TheSeagullDev/wright-1/hardware/wright-I.kicad_pcb

## KiCad design Big Daddy-2025-04-11_172858/Big Daddy-2025-04-11_172858/Big Daddy.kicad_pcb

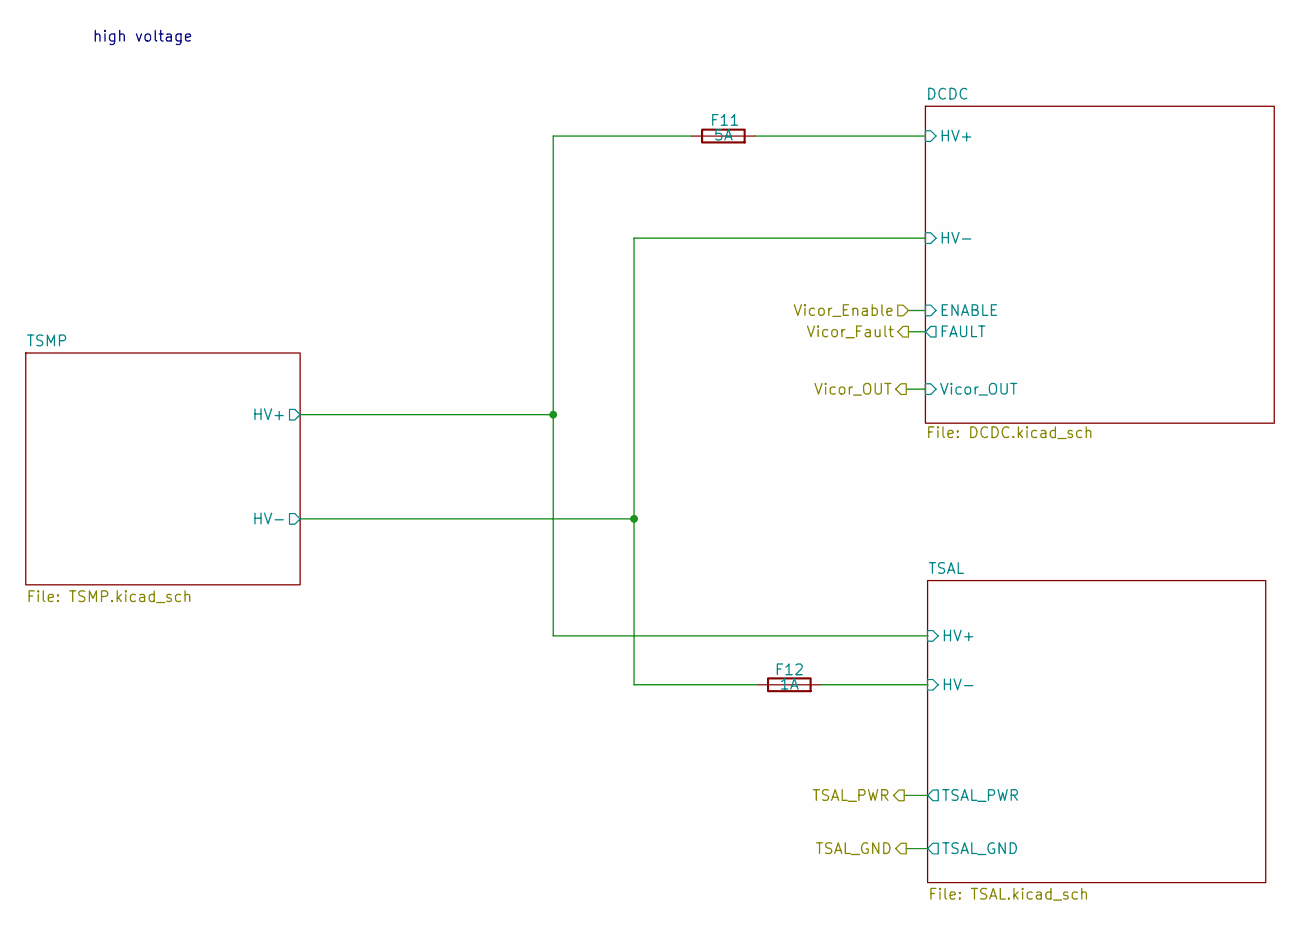
[picture p1: schematic High Voltage.kicad_sch]

Parts:
F11: 5A; Fuseholder_Cylinder-5x20mm_Schurter_0031_8201_Horizontal_Op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
F12: 1A; Fuseholder_Cylinder-5x20mm_Schurter_0031_8201_Horizontal_Op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

Connections:
/High Voltage/DCDC/HV+: F11.2; also elsewhere on the board
/High Voltage/DCDC/HV-: F12.1; also elsewhere on the board
/High Voltage/TSAL/HV+: F11.1; also elsewhere on the board
/High Voltage/TSAL/HV-: F12.2; also elsewhere on the board

Notes on the sheet:
high voltage

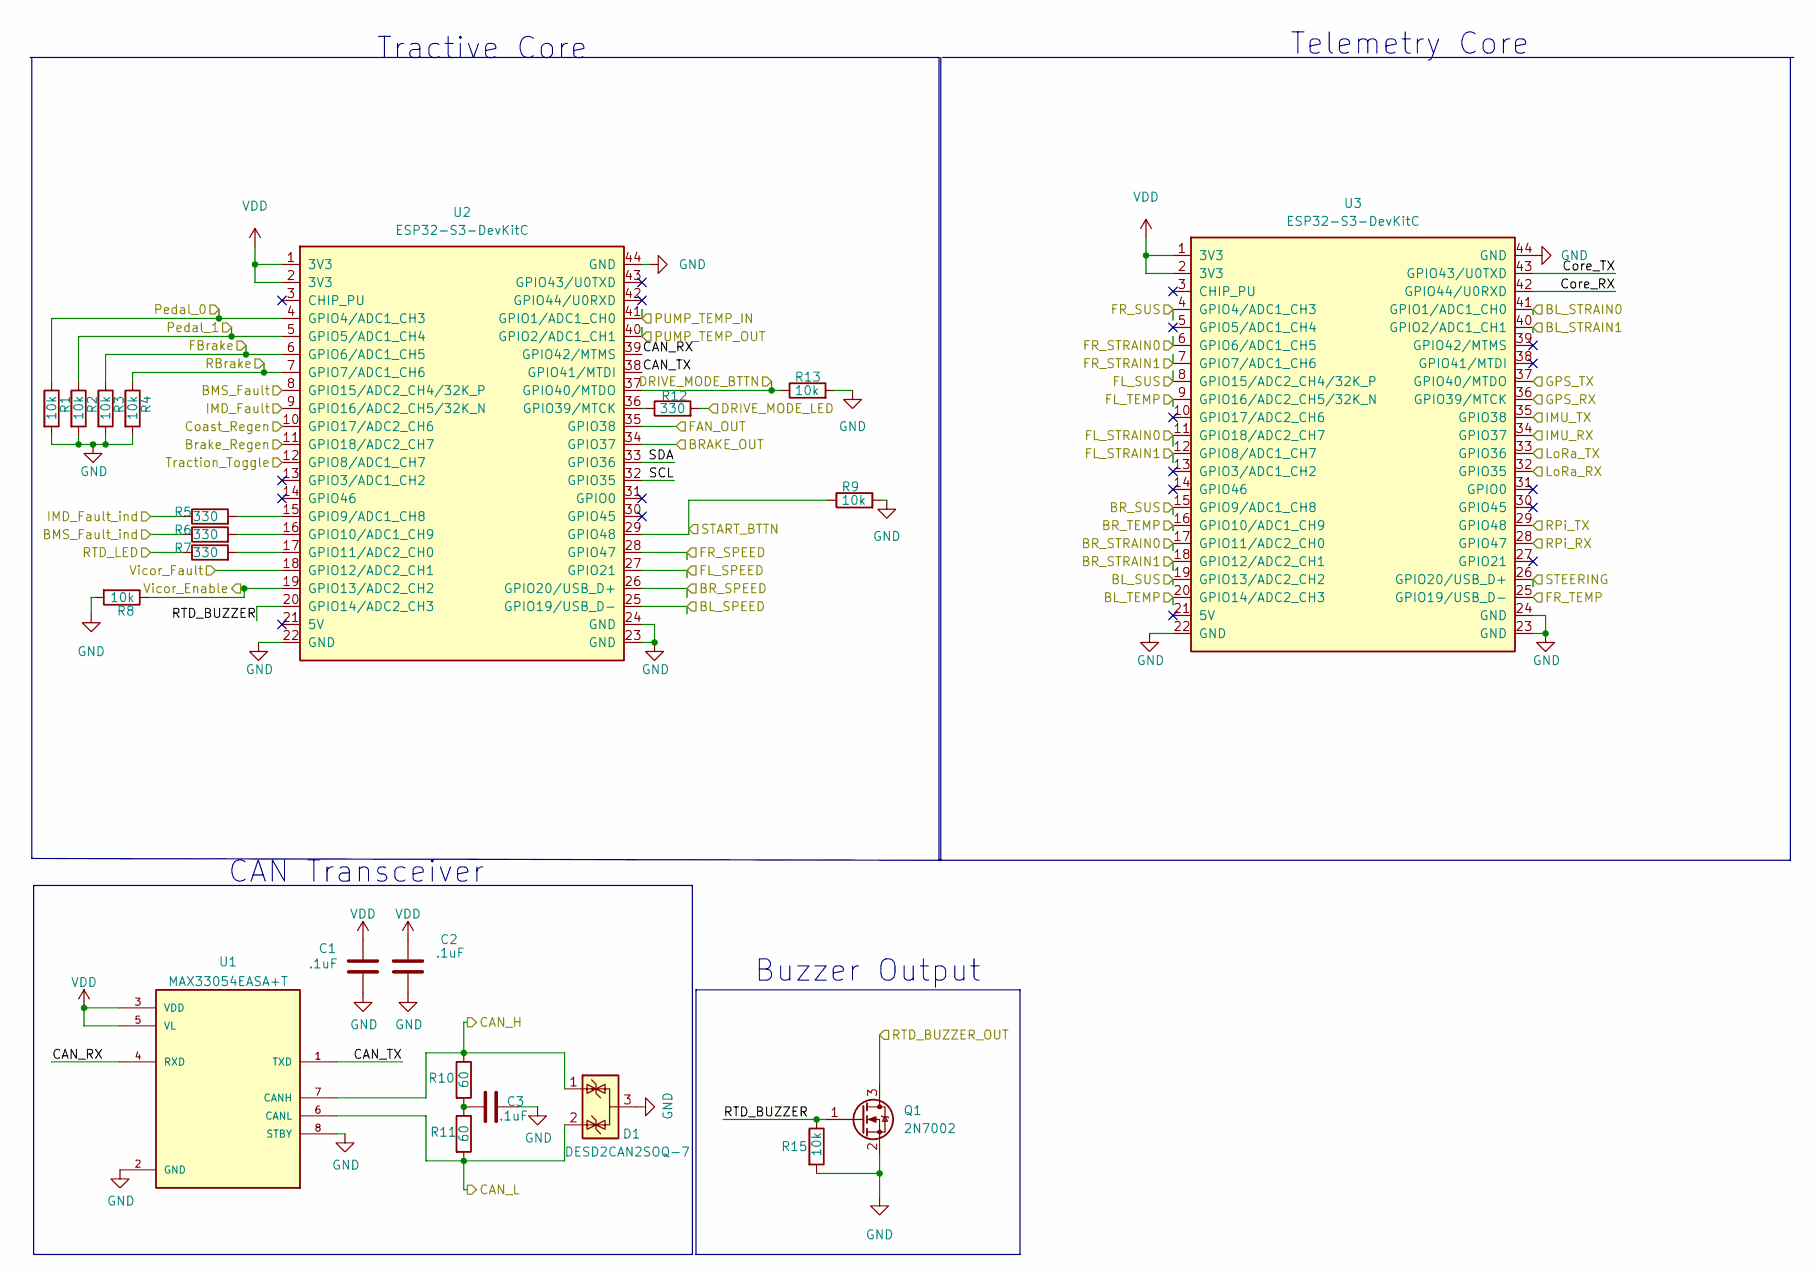
[picture p2: schematic Micro.kicad_sch, Dual Core]

Parts:
C1, C2, C3: .1uF; C_0603_1608Metric_Pad1.08x0.95mm_HandSolder; Manufacturer_Part_Number CC0603KRX7R7BB104; Digikey part number 311-1088-1-ND
D1: DESD2CAN2SOQ-7; SOT-23; Manufacturer_Part_Number DESD2CAN2SOQ-7; Digikey part number DESD2CAN2SOQ-7DICT-ND
Q1: 2N7002; SOT-23; Manufacturer_Part_Number 2N7002; Digikey part number 2N7002NCT-ND
R1, R2, R3, R4, R8, R9, R13, R15: 10k; R_0603_1608Metric_Pad0.98x0.95mm_HandSolder; Manufacturer_Part_Number RK73H1JTTD1002F; Digikey part number 2019-RK73H1JTTD1002FCT-ND
R5, R6, R7, R12: 330; R_0603_1608Metric_Pad0.98x0.95mm_HandSolder; Manufacturer_Part_Number WK73R1JTTD331J; Digikey part number 2019-WK73R1JTTD331JCT-ND
R10, R11: 60; R_0603_1608Metric_Pad0.98x0.95mm_HandSolder; Manufacturer_Part_Number P0603C60R0BNT; Digikey part number 716-P0603C60R0BNTCT-ND
U1: MAX33054EASA+T; SOIC127P600X175-8N; Manufacturer_Part_Number MAX33054EASA+T; Digikey part number 175-MAX33054EASA+TCT-ND
U2, U3: ESP32-S3-DevKitC; Manufacturer_Part_Number ESP32-S3-DEVKITC-1U-N8R8; Digikey part number 1965-ESP32-S3-DEVKITC-1U-N8R8-ND

Connections:
/Connectors/BL_SPEED: U2.25 (GPIO19/USB_D-); also elsewhere on the board
/Connectors/BL_STRAIN0: U3.41 (GPIO1/ADC1_CH0); also elsewhere on the board
/Connectors/BL_STRAIN1: U3.40 (GPIO2/ADC1_CH1); also elsewhere on the board
/Connectors/BL_SUS: U3.19 (GPIO13/ADC2_CH2); also elsewhere on the board
/Connectors/BL_TEMP: U3.20 (GPIO14/ADC2_CH3); also elsewhere on the board
/Connectors/BMS_Fault_ind: R6.1; also elsewhere on the board
/Connectors/BR_SPEED: U2.26 (GPIO20/USB_D+); also elsewhere on the board
/Connectors/BR_STRAIN0: U3.17 (GPIO11/ADC2_CH0); also elsewhere on the board
/Connectors/BR_STRAIN1: U3.18 (GPIO12/ADC2_CH1); also elsewhere on the board
/Connectors/BR_SUS: U3.15 (GPIO9/ADC1_CH8); also elsewhere on the board
/Connectors/BR_TEMP: U3.16 (GPIO10/ADC1_CH9); also elsewhere on the board
/Connectors/Brake_Regen: U2.11 (GPIO18/ADC2_CH7); also elsewhere on the board
/Connectors/CAN_H: D1.1 (K), R10.1, U1.7 (CANH); also elsewhere on the board
/Connectors/CAN_L: D1.2 (K), R11.2, U1.6 (CANL); also elsewhere on the board
/Connectors/Coast_Regen: U2.10 (GPIO17/ADC2_CH6); also elsewhere on the board
/Connectors/DRIVE_MODE_BTTN: R13.1, U2.37 (GPIO40/MTDO); also elsewhere on the board
/Connectors/DRIVE_MODE_LED: R12.2; also elsewhere on the board
/Connectors/FBrake: R3.1, U2.6 (GPIO6/ADC1_CH5); also elsewhere on the board
/Connectors/FL_SPEED: U2.27 (GPIO21); also elsewhere on the board
/Connectors/FL_STRAIN0: U3.11 (GPIO18/ADC2_CH7); also elsewhere on the board
/Connectors/FL_STRAIN1: U3.12 (GPIO8/ADC1_CH7); also elsewhere on the board
/Connectors/FL_SUS: U3.8 (GPIO15/ADC2_CH4/32K_P); also elsewhere on the board
/Connectors/FL_TEMP: U3.9 (GPIO16/ADC2_CH5/32K_N); also elsewhere on the board
/Connectors/FR_SPEED: U2.28 (GPIO47); also elsewhere on the board
/Connectors/FR_STRAIN0: U3.6 (GPIO6/ADC1_CH5); also elsewhere on the board
/Connectors/FR_STRAIN1: U3.7 (GPIO7/ADC1_CH6); also elsewhere on the board
/Connectors/FR_SUS: U3.4 (GPIO4/ADC1_CH3); also elsewhere on the board
/Connectors/FR_TEMP: U3.25 (GPIO19/USB_D-); also elsewhere on the board
/Connectors/GPS_RX: U3.36 (GPIO39/MTCK); also elsewhere on the board
/Connectors/GPS_TX: U3.37 (GPIO40/MTDO); also elsewhere on the board
/Connectors/IMD_Fault_ind: R5.1; also elsewhere on the board
/Connectors/IMU_RX: U3.34 (GPIO37); also elsewhere on the board
/Connectors/IMU_TX: U3.35 (GPIO38); also elsewhere on the board
/Connectors/LoRa_RX: U3.32 (GPIO35); also elsewhere on the board
/Connectors/LoRa_TX: U3.33 (GPIO36); also elsewhere on the board
/Connectors/PUMP_TEMP_IN: U2.41 (GPIO1/ADC1_CH0); also elsewhere on the board
/Connectors/PUMP_TEMP_OUT: U2.40 (GPIO2/ADC1_CH1); also elsewhere on the board
/Connectors/Pedal_0: R1.1, U2.4 (GPIO4/ADC1_CH3); also elsewhere on the board
/Connectors/Pedal_1: R2.1, U2.5 (GPIO5/ADC1_CH4); also elsewhere on the board
/Connectors/RBrake: R4.1, U2.7 (GPIO7/ADC1_CH6); also elsewhere on the board
/Connectors/RPi_RX: U3.28 (GPIO47); also elsewhere on the board
/Connectors/RPi_TX: U3.29 (GPIO48); also elsewhere on the board
/Connectors/RTD_BUZZER_OUT: Q1.3 (D); also elsewhere on the board
/Connectors/RTD_LED: R7.1; also elsewhere on the board
/Connectors/START_BTTN: R9.1, U2.29 (GPIO48); also elsewhere on the board
/Connectors/STEERING: U3.26 (GPIO20/USB_D+); also elsewhere on the board
/Cooling/Brake_SIG_Out: U2.34 (GPIO37); also elsewhere on the board
/Cooling/Fan_SIG_Out: U2.35 (GPIO38); also elsewhere on the board
/High Voltage/Vicor_Enable: R8.1, U2.19 (GPIO13/ADC2_CH2); also elsewhere on the board
/High Voltage/Vicor_Fault: U2.18 (GPIO12/ADC2_CH1); also elsewhere on the board
/Latching/IMD_IND: U2.9 (GPIO16/ADC2_CH5/32K_N); also elsewhere on the board
/Microcontrolller/CAN_RX: U1.4 (RXD), U2.39 (GPIO42/MTMS)
/Microcontrolller/CAN_TX: U1.1 (TXD), U2.38 (GPIO41/MTDI)
/Microcontrolller/Core_RX: U3.42 (GPIO44/U0RXD)
/Microcontrolller/Core_TX: U3.43 (GPIO43/U0TXD)
/Microcontrolller/RTD_BUZZER: Q1.1 (G), R15.1, U2.20 (GPIO14/ADC2_CH3)
/Microcontrolller/SCL: U2.32 (GPIO35)
/Microcontrolller/SDA: U2.33 (GPIO36)
/Microcontrolller/Traction_Toggle: U2.12 (GPIO8/ADC1_CH7)
GND: C1.2, C2.2, C3.2, D1.3 (A), Q1.2 (S), R1.2, R2.2, R3.2, R4.2, R8.2, R9.2, R13.2, R15.2, U1.2 (GND), U1.8 (STBY), U2.22 (GND), U2.23 (GND), U2.24 (GND), U2.44 (GND), U3.22 (GND), U3.23 (GND), U3.24 (GND), U3.44 (GND); also elsewhere on the board
unnamed: C3.1, R10.2, R11.1
unnamed: R5.2, U2.15 (GPIO9/ADC1_CH8)
unnamed: R6.2, U2.16 (GPIO10/ADC1_CH9)
unnamed: R7.2, U2.17 (GPIO11/ADC2_CH0)
unnamed: R12.1, U2.36 (GPIO39/MTCK)
VDD: C1.1, C2.1, U1.3 (VDD), U1.5 (VL), U2.1 (3V3), U2.2 (3V3), U3.1 (3V3), U3.2 (3V3); also elsewhere on the board

Notes on the sheet:
CAN Transceiver
Buzzer Output
Telemetry Core
Tractive Core

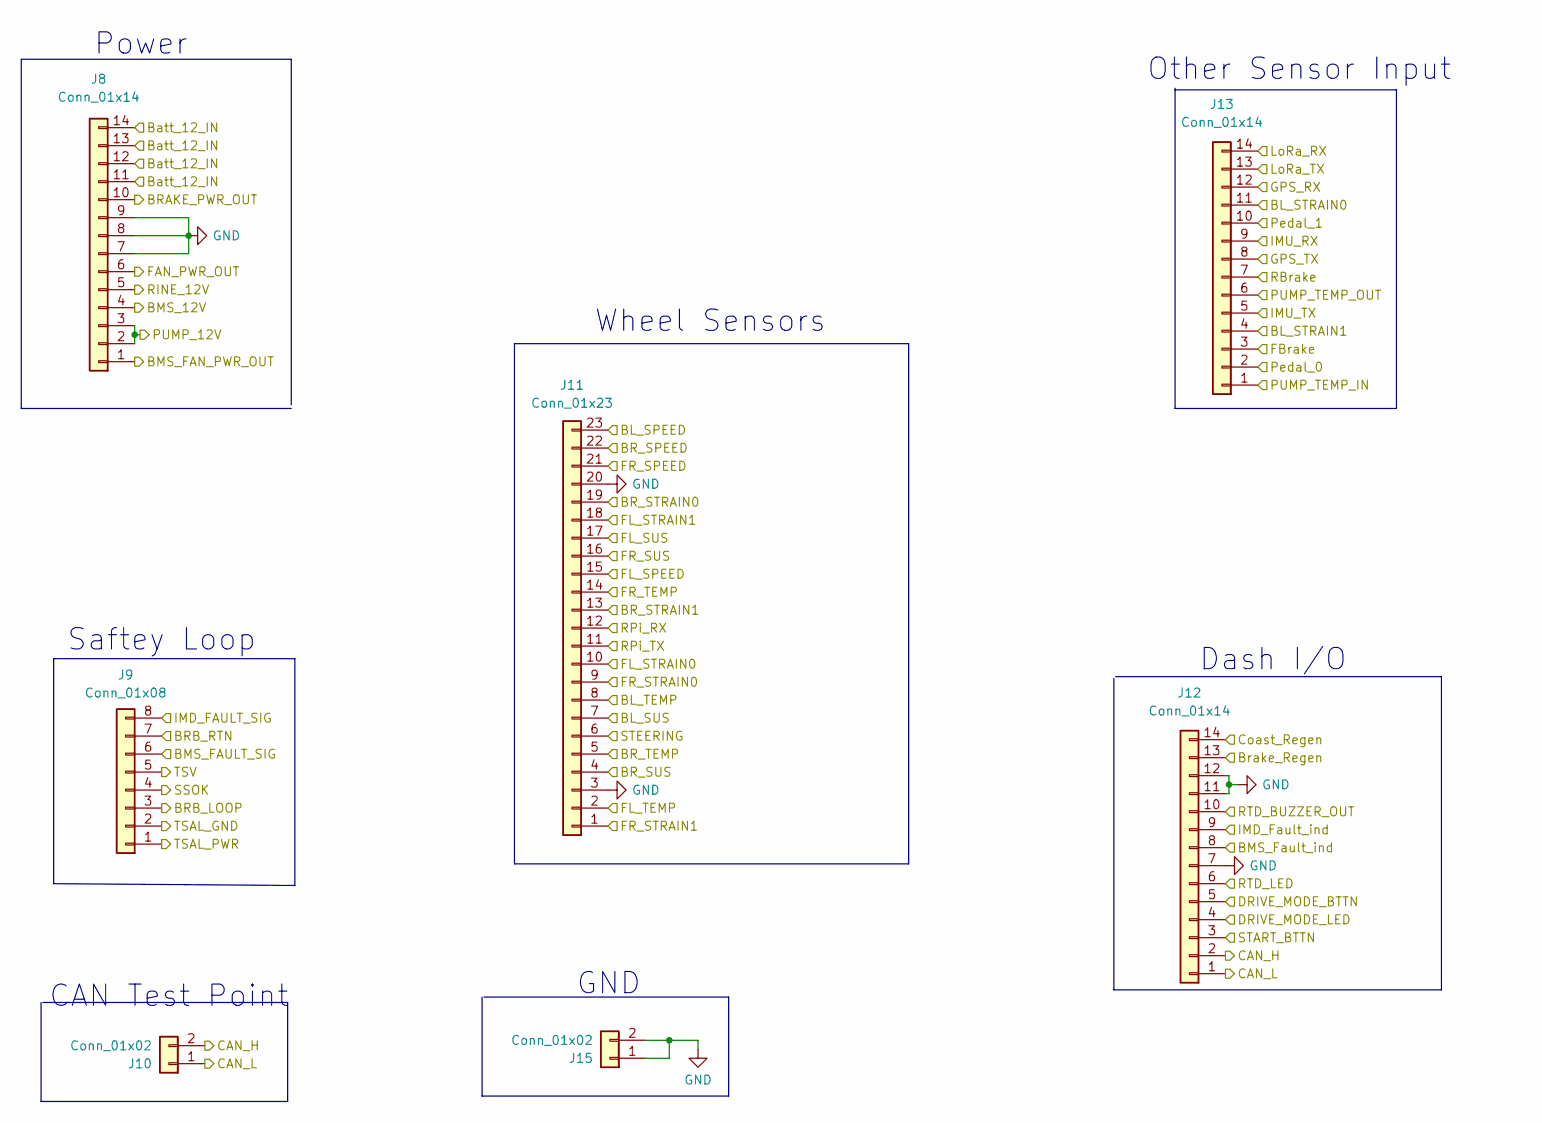
[picture p3: schematic Connectors.kicad_sch]

Parts:
J8, J12, J13: Conn_01x14; TE_1-776266-1_14pin_Horizontal
J9: Conn_01x08; TE_1-776280-1_8pin_Horizontal
J10, J15: Conn_01x02; TE_MATE-N-LOK_1-770866-x_1x02_P4.14mm_Vertical
J11: Conn_01x23; TE_1-770669-1_23pin_Horizontal

Connections:
/Connectors/BL_SPEED: J11.23; also elsewhere on the board
/Connectors/BL_STRAIN0: J13.11; also elsewhere on the board
/Connectors/BL_STRAIN1: J13.4; also elsewhere on the board
/Connectors/BL_SUS: J11.7; also elsewhere on the board
/Connectors/BL_TEMP: J11.8; also elsewhere on the board
/Connectors/BMS_12V: J8.4; also elsewhere on the board
/Connectors/BMS_FAN_PWR_OUT: J8.1; also elsewhere on the board
/Connectors/BMS_Fault_ind: J12.8; also elsewhere on the board
/Connectors/BRAKE_PWR_OUT: J8.10; also elsewhere on the board
/Connectors/BRB_LOOP: J9.3; also elsewhere on the board
/Connectors/BRB_RTN: J9.7; also elsewhere on the board
/Connectors/BR_SPEED: J11.22; also elsewhere on the board
/Connectors/BR_STRAIN0: J11.19; also elsewhere on the board
/Connectors/BR_STRAIN1: J11.13; also elsewhere on the board
/Connectors/BR_SUS: J11.4; also elsewhere on the board
/Connectors/BR_TEMP: J11.5; also elsewhere on the board
/Connectors/Batt_12_IN: J8.11, J8.12, J8.13, J8.14; also elsewhere on the board
/Connectors/Brake_Regen: J12.13; also elsewhere on the board
/Connectors/CAN_H: J10.2, J12.2; also elsewhere on the board
/Connectors/CAN_L: J10.1, J12.1; also elsewhere on the board
/Connectors/Coast_Regen: J12.14; also elsewhere on the board
/Connectors/DRIVE_MODE_BTTN: J12.5; also elsewhere on the board
/Connectors/DRIVE_MODE_LED: J12.4; also elsewhere on the board
/Connectors/FAN_PWR_OUT: J8.6; also elsewhere on the board
/Connectors/FBrake: J13.3; also elsewhere on the board
/Connectors/FL_SPEED: J11.15; also elsewhere on the board
/Connectors/FL_STRAIN0: J11.10; also elsewhere on the board
/Connectors/FL_STRAIN1: J11.18; also elsewhere on the board
/Connectors/FL_SUS: J11.17; also elsewhere on the board
/Connectors/FL_TEMP: J11.2; also elsewhere on the board
/Connectors/FR_SPEED: J11.21; also elsewhere on the board
/Connectors/FR_STRAIN0: J11.9; also elsewhere on the board
/Connectors/FR_STRAIN1: J11.1; also elsewhere on the board
/Connectors/FR_SUS: J11.16; also elsewhere on the board
/Connectors/FR_TEMP: J11.14; also elsewhere on the board
/Connectors/GPS_RX: J13.12; also elsewhere on the board
/Connectors/GPS_TX: J13.8; also elsewhere on the board
/Connectors/IMD_FAULT_SIG: J9.8; also elsewhere on the board
/Connectors/IMD_Fault_ind: J12.9; also elsewhere on the board
/Connectors/IMU_RX: J13.9; also elsewhere on the board
/Connectors/IMU_TX: J13.5; also elsewhere on the board
/Connectors/LoRa_RX: J13.14; also elsewhere on the board
/Connectors/LoRa_TX: J13.13; also elsewhere on the board
/Connectors/PUMP_12V: J8.2, J8.3; also elsewhere on the board
/Connectors/PUMP_TEMP_IN: J13.1; also elsewhere on the board
/Connectors/PUMP_TEMP_OUT: J13.6; also elsewhere on the board
/Connectors/Pedal_0: J13.2; also elsewhere on the board
/Connectors/Pedal_1: J13.10; also elsewhere on the board
/Connectors/RBrake: J13.7; also elsewhere on the board
/Connectors/RINE_12V: J8.5; also elsewhere on the board
/Connectors/RPi_RX: J11.12; also elsewhere on the board
/Connectors/RPi_TX: J11.11; also elsewhere on the board
/Connectors/RTD_BUZZER_OUT: J12.10; also elsewhere on the board
/Connectors/RTD_LED: J12.6; also elsewhere on the board
/Connectors/SSOK: J9.4, J9.5; also elsewhere on the board
/Connectors/START_BTTN: J12.3; also elsewhere on the board
/Connectors/STEERING: J11.6; also elsewhere on the board
/Connectors/TSAL_GND: J9.2; also elsewhere on the board
/Connectors/TSAL_PWR: J9.1; also elsewhere on the board
GND: J8.7, J8.8, J8.9, J11.3, J11.20, J12.7, J12.11, J12.12, J15.1, J15.2; also elsewhere on the board

Notes on the sheet:
Power
Wheel Sensors
CAN Test Point
GND
Other Sensor Input
Dash I/O
Saftey Loop

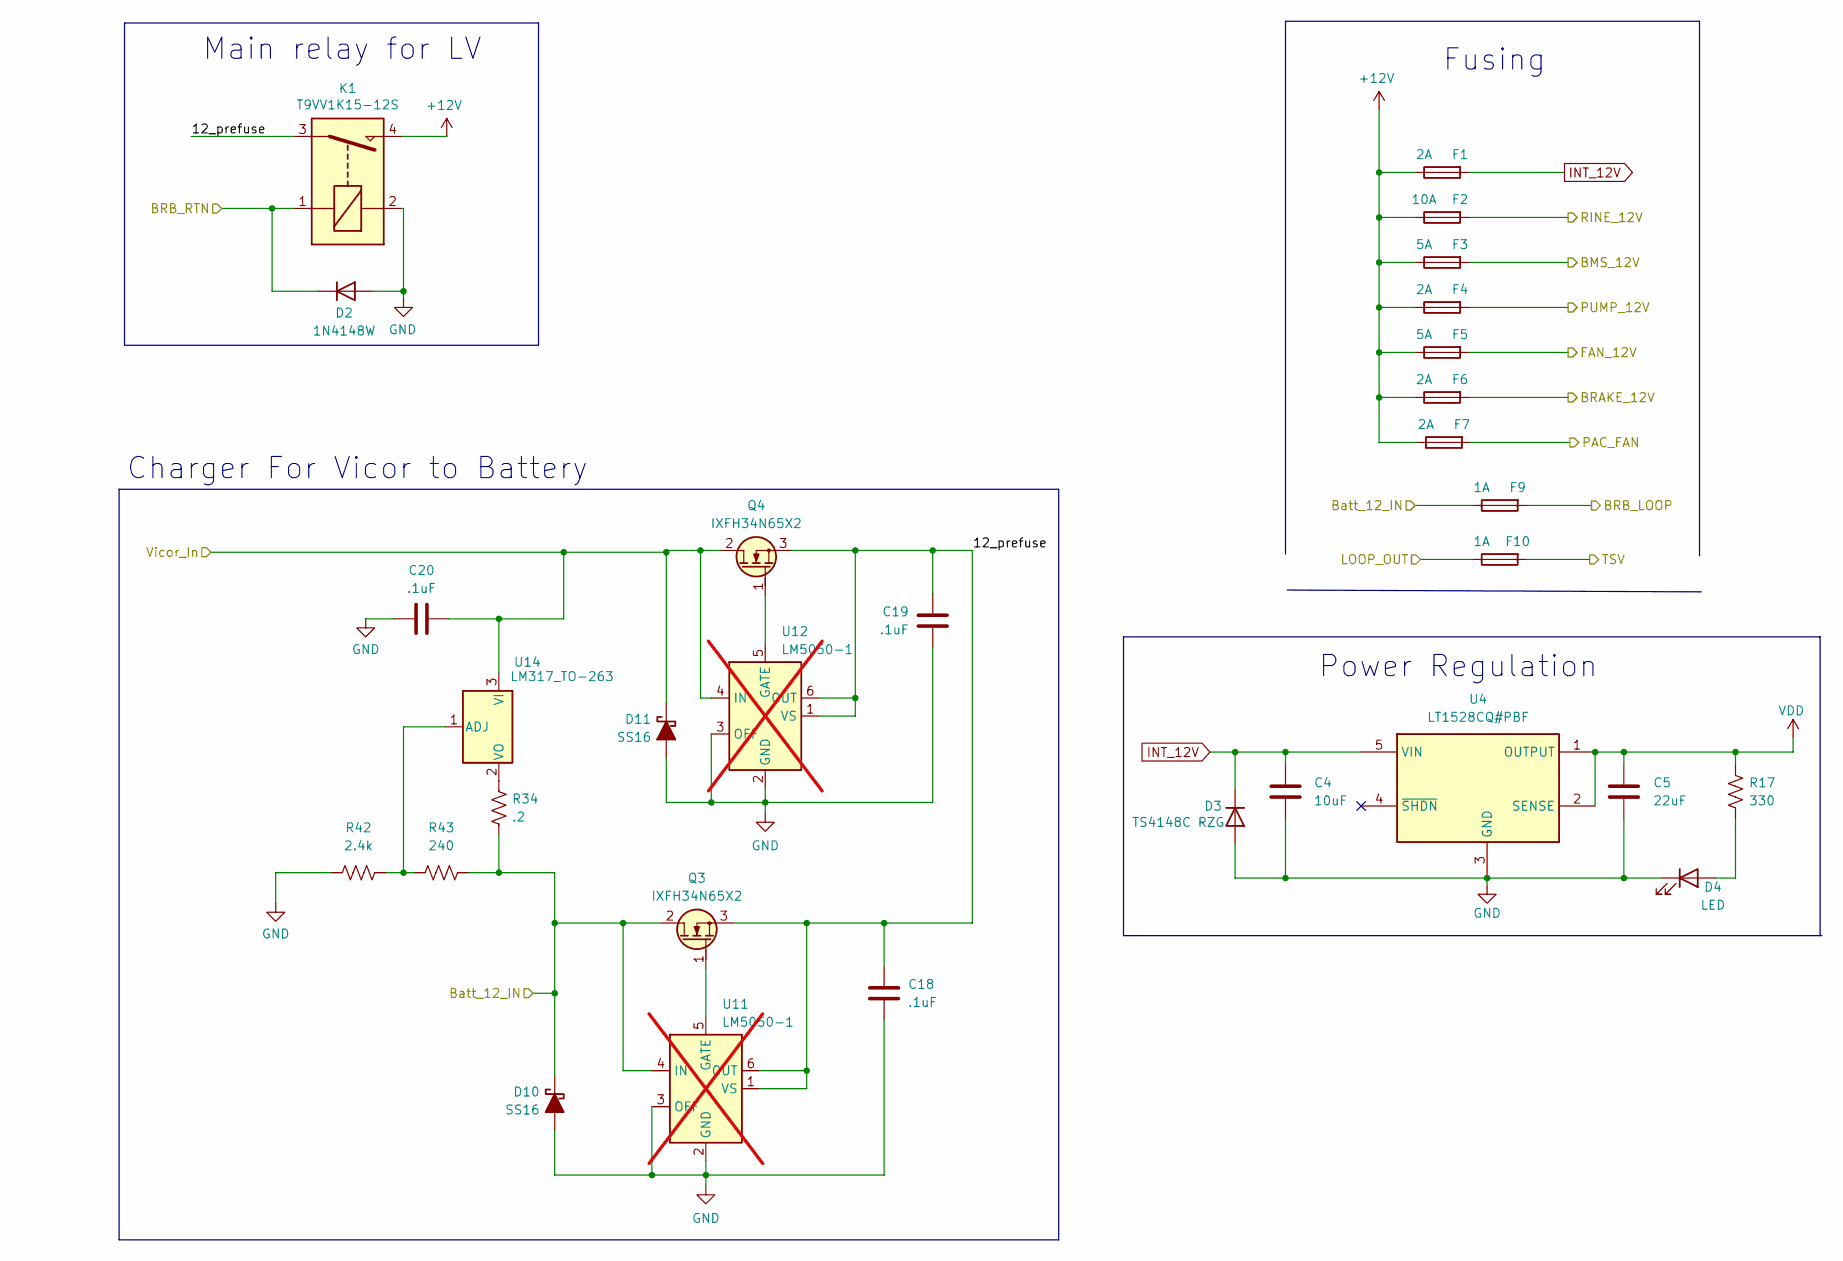
[picture p4: schematic Fusing.kicad_sch]

Parts:
C4: 10uF; C_0603_1608Metric_Pad1.08x0.95mm_HandSolder; Manufacturer_Part_Number CL10A106KQ8NNNC; Digikey part number 1276-1038-1-ND
C5: 22uF; C_0603_1608Metric_Pad1.08x0.95mm_HandSolder; Manufacturer_Part_Number CL10A226MP8NUNE; Digikey part number 1276-1274-1-ND
C18, C19, C20: .1uF; C_0603_1608Metric_Pad1.08x0.95mm_HandSolder; Manufacturer_Part_Number CC0603KRX7R7BB104; Digikey part number 311-1088-1-ND
D2: 1N4148W; D_SOD-123; Manufacturer_Part_Number 1N4148W; Digikey part number 1655-1N4148WCT-ND
D3: TS4148C RZG; D_0603_1608Metric_Pad1.05x0.95mm_HandSolder; Manufacturer_Part_Number TS4148 RCG; Digikey part number 1801-TS4148RCGCT-ND
D4: LED; LED_0603_1608Metric_Pad1.05x0.95mm_HandSolder
D10, D11: SS16; D_SMA; Manufacturer_Part_Number SS16T3G; Digikey part number SS16T3GOSCT-ND
F1, F4, F6, F7: 2A; Fuseholder_Blade_Mini_Keystone_3568
F2: 10A; Fuseholder_Blade_Mini_Keystone_3568
F3, F5: 5A; Fuseholder_Blade_Mini_Keystone_3568
F9, F10: 1A; Fuseholder_Blade_Mini_Keystone_3568
K1: T9VV1K15-12S; RELAY_T9VV1K15-12S; Manufacturer_Part_Number T9VV1K15-12S; Digikey part number PB2352-ND
Q3, Q4: IXFH34N65X2; TO-247-3_Vertical_GDS; Manufacturer_Part_Number IXFH34N65X2; Digikey part number IXFH34N65X2-ND
R17: 330; R_0603_1608Metric_Pad0.98x0.95mm_HandSolder; Manufacturer_Part_Number WK73R1JTTD331J; Digikey part number 2019-WK73R1JTTD331JCT-ND
R34: .2; R_0805_2012Metric_Pad1.20x1.40mm_HandSolder; Manufacturer_Part_Number ERJ-6DSFR20V; Digikey part number P19315CT-ND
R42: 2.4k; R_0603_1608Metric_Pad0.98x0.95mm_HandSolder; Manufacturer_Part_Number RC0603JR-072K4L; Digikey part number 311-2.4KGRCT-ND
R43: 240; R_0603_1608Metric_Pad0.98x0.95mm_HandSolder; Manufacturer_Part_Number CRCW0603240RFKEAC; Digikey part number 541-5280-1-ND
U4: LT1528CQ#PBF; LT1528CQPBF; Mouser Part Number 584-LT1528CQ#PBF
U11, U12: LM5050-1; TSOT-23-6; Manufacturer_Part_Number LM5050MKX-1/NOPB; Digikey part number 296-46427-1-ND; not fitted
U14: LM317_TO-263; TO-263-2

Connections:
+12V: F1.1, F2.1, F3.1, F4.1, F5.1, F6.1, F7.1, K1.4
/Connectors/BMS_12V: F3.2; also elsewhere on the board
/Connectors/BMS_FAN_PWR_OUT: F7.2; also elsewhere on the board
/Connectors/BRB_LOOP: F9.2; also elsewhere on the board
/Connectors/BRB_RTN: D2.1 (K), K1.1; also elsewhere on the board
/Connectors/Batt_12_IN: D10.1 (K), F9.1, Q3.2 (D), R34.1, R43.2, U11.4 (IN); also elsewhere on the board
/Connectors/PUMP_12V: F4.2; also elsewhere on the board
/Connectors/RINE_12V: F2.2; also elsewhere on the board
/Connectors/SSOK: F10.2; also elsewhere on the board
/Cooling/BRAKE_12V: F6.2; also elsewhere on the board
/Cooling/FAN_12V: F5.2; also elsewhere on the board
/Fusing/12_prefuse: C18.1, C19.1, K1.3, Q3.3 (S), Q4.3 (S), U11.1 (VS), U11.6 (OUT), U12.1 (VS), U12.6 (OUT)
/Fusing/LOOP_OUT: F10.1; also elsewhere on the board
/Fusing/Vicor_In: C20.1, D11.1 (K), Q4.2 (D), U12.4 (IN), U14.3 (VI); also elsewhere on the board
GND: C4.2, C5.2, C18.2, C19.2, C20.2, D2.2 (A), D3.2 (A), D4.1 (K), D10.2 (A), D11.2 (A), K1.2, R42.1, U4.3 (GND), U11.2 (GND), U11.3 (OFF), U12.2 (GND), U12.3 (OFF); also elsewhere on the board
INT_12V: C4.1, D3.1 (K), F1.2, U4.5 (VIN); also elsewhere on the board
unnamed: D4.2 (A), R17.2
unnamed: Q3.1 (G), U11.5 (GATE)
unnamed: Q4.1 (G), U12.5 (GATE)
unnamed: R42.2, R43.1, U14.1 (ADJ)
unnamed: R34.2, U14.2 (VO)
VDD: C5.1, R17.1, U4.1 (OUTPUT), U4.2 (SENSE); also elsewhere on the board

Notes on the sheet:
Fusing
Power Regulation
Charger For Vicor to Battery
Main relay for LV

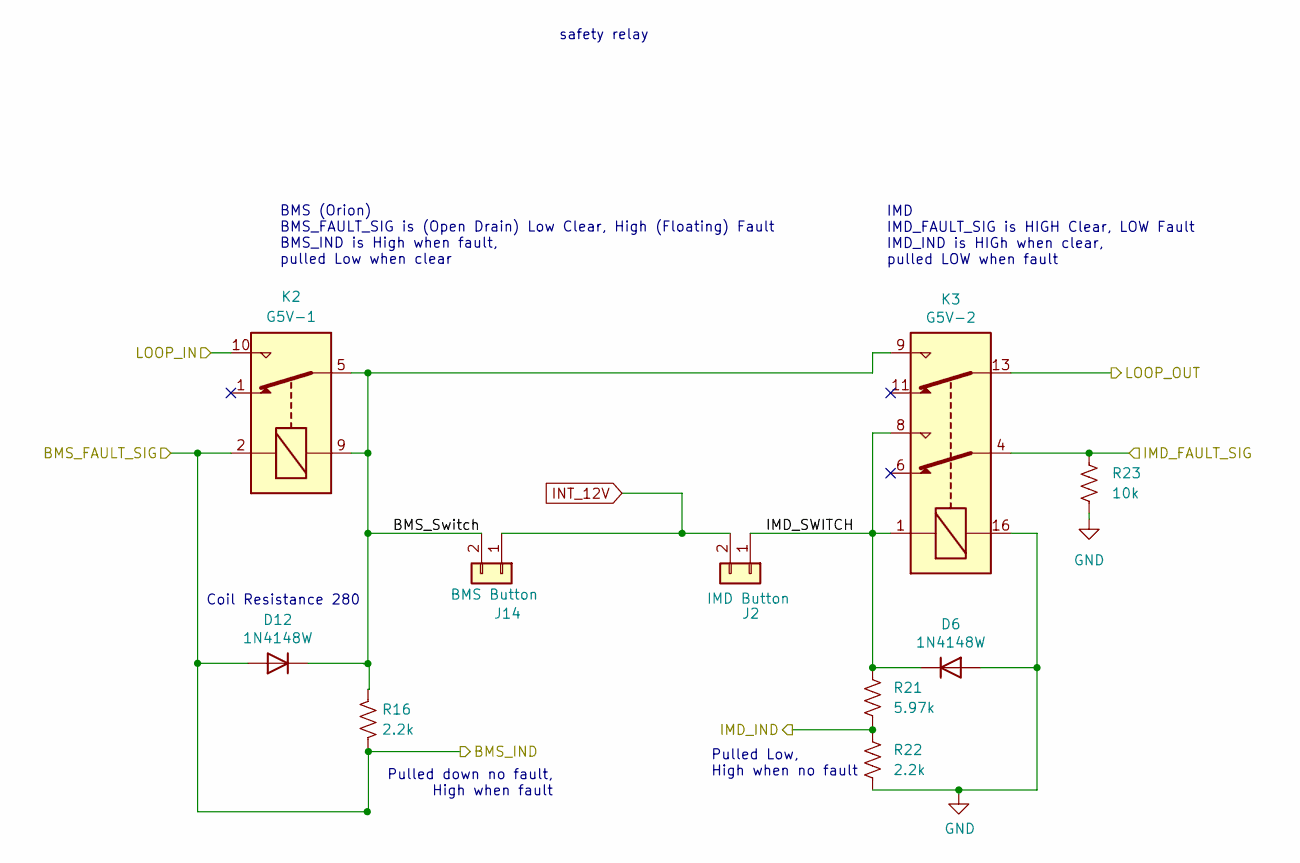
[picture p5: schematic Latching.kicad_sch]

Parts:
D6, D12: 1N4148W; D_SOD-123; Manufacturer_Part_Number 1N4148W; Digikey part number 1655-1N4148WCT-ND
J2: IMD Button; JST_XH_B2B-XH-AM_1x02_P2.50mm_Vertical
J14: BMS Button; JST_XH_B2B-XH-AM_1x02_P2.50mm_Vertical
K2: G5V-1; Relay_SPDT_Omron_G5V-1
K3: G5V-2; Relay_DPDT_Omron_G5V-2; Manufacturer_Part_Number G5V-2 DC12; Digikey part number 39-G5V-2DC12-ND
R16: 2.2k; R_0603_1608Metric_Pad0.98x0.95mm_HandSolder; Manufacturer_Part_Number RN73R1JTTD5971B25; Digikey part number 2019-RN73R1JTTD5971B25CT-ND
R21: 5.97k; R_0603_1608Metric_Pad0.98x0.95mm_HandSolder; Manufacturer_Part_Number RN73R1JTTD5971B25; Digikey part number 2019-RN73R1JTTD5971B25CT-ND
R22: 2.2k; R_0603_1608Metric_Pad0.98x0.95mm_HandSolder; Manufacturer_Part_Number CRGCQ0603F2K2; Digikey part number A129692CT-ND
R23: 10k; R_0603_1608Metric_Pad0.98x0.95mm_HandSolder; Manufacturer_Part_Number RK73H1JTTD1002F; Digikey part number 2019-RK73H1JTTD1002FCT-ND

Connections:
/Connectors/IMD_FAULT_SIG: K3.4, R23.1; also elsewhere on the board
/Fusing/LOOP_OUT: K3.13; also elsewhere on the board
/Latching/IMD_IND: R21.2, R22.1; also elsewhere on the board
/Latching/IMD_SWITCH: D6.1 (K), J2.1, K3.1, K3.8, R21.1
GND: D6.2 (A), K3.16, R22.2, R23.2; also elsewhere on the board
INT_12V: J2.2, J14.1, K2.10; also elsewhere on the board

Notes on the sheet:
Coil Resistance 280
Pulled down no fault, High when fault
safety relay
BMS (Orion) BMS_FAULT_SIG is (Open Drain) Low Clear, High (Floating) Fault BMS_IND is High when fault, pulled Low when clear
Pulled Low, High when no fault
IMD IMD_FAULT_SIG is HIGH Clear, LOW Fault IMD_IND is HIGh when clear, pulled LOW when fault

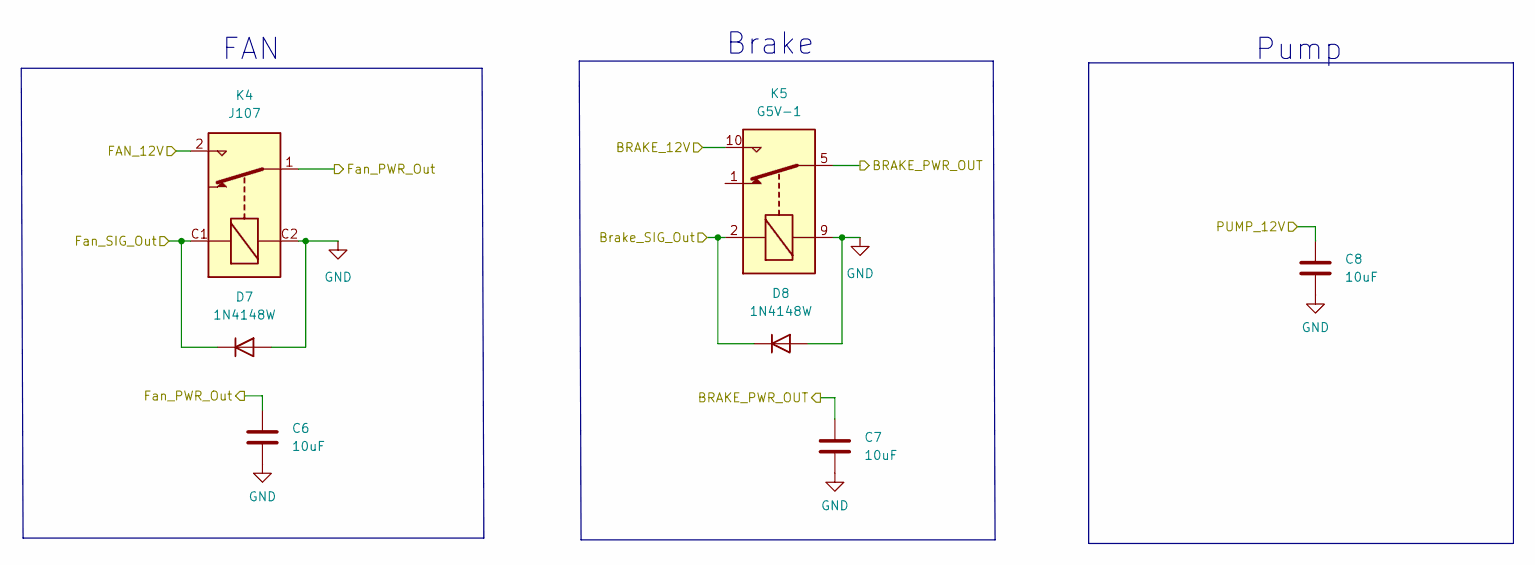
[picture p6: schematic Cooling.kicad_sch]

Parts:
C6, C7, C8: 10uF; C_0603_1608Metric_Pad1.08x0.95mm_HandSolder; Manufacturer_Part_Number CL10A106KQ8NNNC; Digikey part number 1276-1038-1-ND
D7, D8: 1N4148W; D_SOD-123; Manufacturer_Part_Number 1N4148W; Digikey part number 1655-1N4148WCT-ND
K4: J107; J1071AS3VDC
K5: G5V-1; Relay_SPDT_Omron_G5V-1; Manufacturer_Part_Number G5V-1-T90 DC24; Digikey part number Z6372-ND

Connections:
/Connectors/BRAKE_PWR_OUT: C7.1, K5.5, K5.6; also elsewhere on the board
/Connectors/FAN_PWR_OUT: C6.1, K4.1; also elsewhere on the board
/Connectors/PUMP_12V: C8.1; also elsewhere on the board
/Cooling/BRAKE_12V: K5.10; also elsewhere on the board
/Cooling/Brake_SIG_Out: D8.1 (K), K5.2; also elsewhere on the board
/Cooling/FAN_12V: K4.2; also elsewhere on the board
/Cooling/Fan_SIG_Out: D7.1 (K), K4.C1; also elsewhere on the board
GND: C6.2, C7.2, C8.2, D7.2 (A), D8.2 (A), K4.C2, K5.9; also elsewhere on the board

Notes on the sheet:
Brake
FAN
Pump

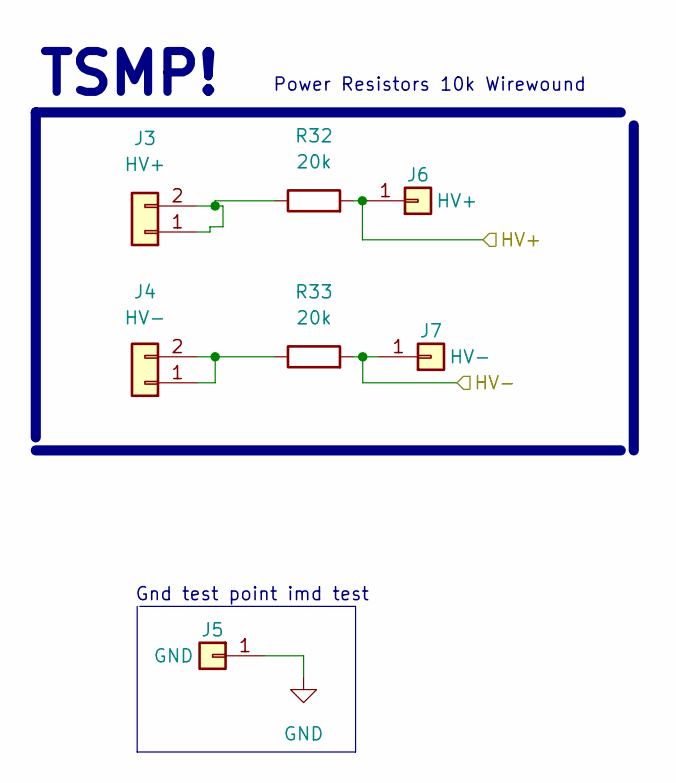
[picture p7: schematic TSMP.kicad_sch]

Parts:
J3: HV+; Hirose_DF63R-2P-3.96DSA_1x02_P3.96mm_Vertical
J4: HV-; Hirose_DF63R-2P-3.96DSA_1x02_P3.96mm_Vertical
J5: GND; Hirose_DF63M-1P-3.96DSA_1x01_P3.96mm_Vertical
J6: HV+; Hirose_DF63M-1P-3.96DSA_1x01_P3.96mm_Vertical
J7: HV-; Hirose_DF63M-1P-3.96DSA_1x01_P3.96mm_Vertical
R32, R33: 20k; R_Axial_DIN0309_L9.0mm_D3.2mm_P5.08mm_Vertical; Manufacturer_Part_Number CF18JT20K0; Digikey part number CF18JT20K0CT-ND

Connections:
/High Voltage/DCDC/HV-: J7.1, R33.2; also elsewhere on the board
/High Voltage/TSAL/HV+: J6.1, R32.2; also elsewhere on the board
GND: J5.1; also elsewhere on the board
unnamed: J3.1, J3.2, R32.1
unnamed: J4.1, J4.2, R33.1

Notes on the sheet:
TSMP!
Power Resistors 10k Wirewound
Gnd test point imd test
