TheSeagullDev/wright-1/hardware/wright-I.kicad_pcb

## KiCad design Big Daddy-2025-04-11_172858/Big Daddy-2025-04-11_172858/Big Daddy.kicad_pcb (continued)

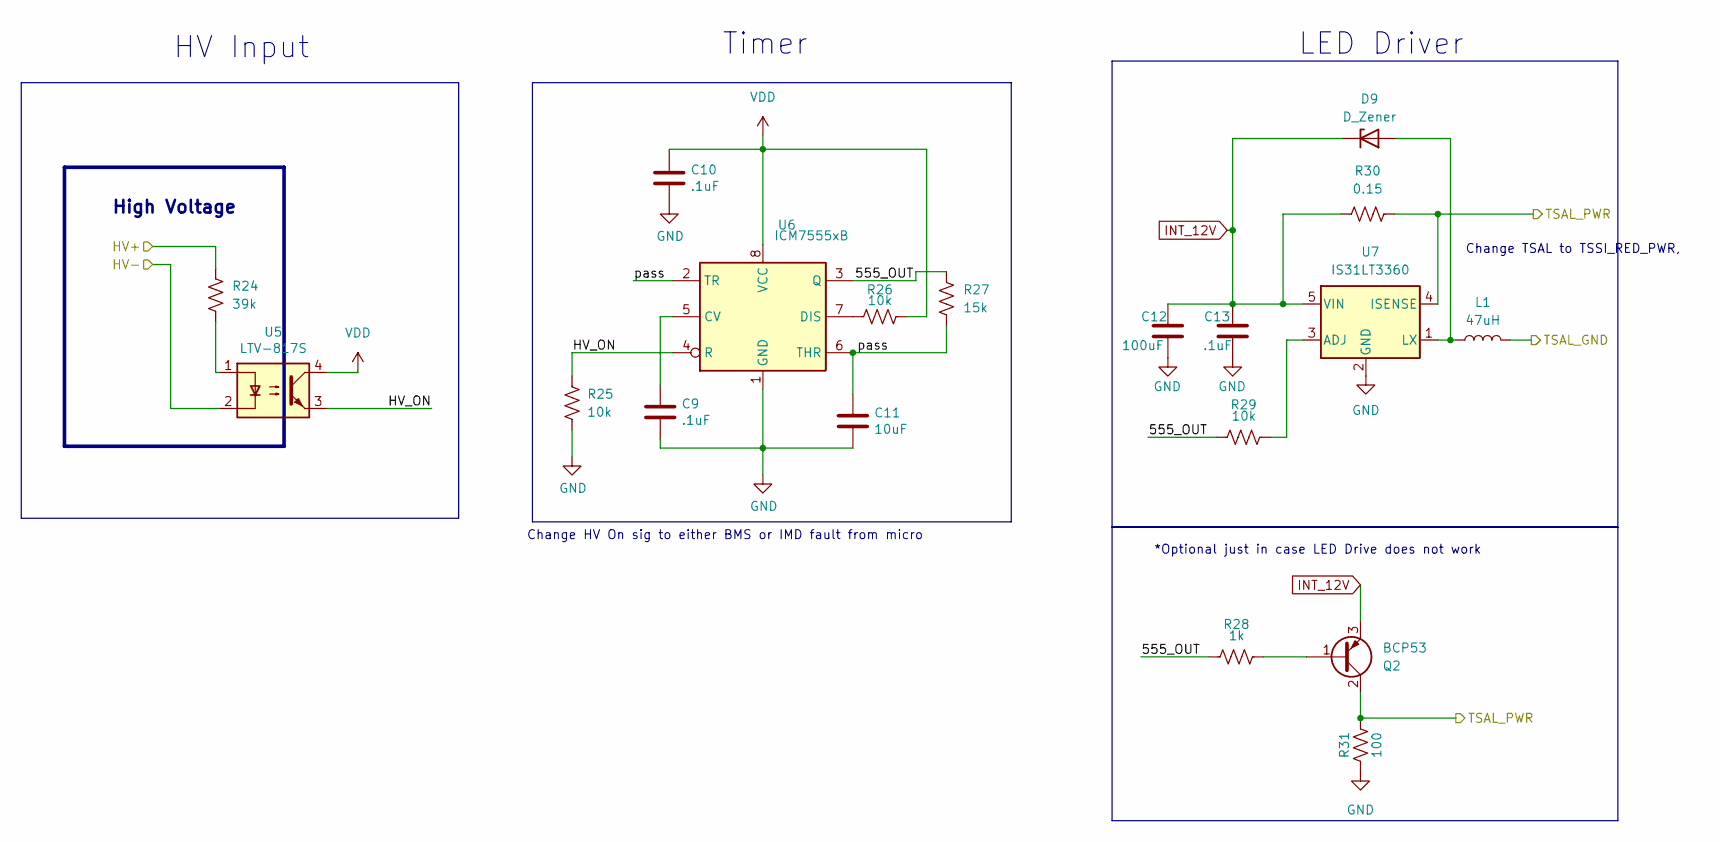
[picture p8: schematic TSAL.kicad_sch]

Parts:
C9, C10, C13: .1uF; C_0603_1608Metric_Pad1.08x0.95mm_HandSolder; Manufacturer_Part_Number CC0603KRX7R7BB104; Digikey part number 311-1088-1-ND
C11: 10uF; C_0603_1608Metric_Pad1.08x0.95mm_HandSolder; Manufacturer_Part_Number CL10A106KQ8NNNC; Digikey part number 1276-1038-1-ND
C12: 100uF; CP_Radial_D10.0mm_P5.00mm
D9: D_Zener; D_SOD-123; Manufacturer_Part_Number MMSZ5231B-7-F; Digikey part number MMSZ5231B-FDICT-ND
L1: 47uH; L_0603_1608Metric_Pad1.05x0.95mm_HandSolder; Manufacturer_Part_Number LBMF1608T470K; Digikey part number 587-1716-1-ND
Q2: BCP53; SOT-223-3_TabPin2; Manufacturer_Part_Number BCP53; Digikey part number BCP53FSCT-ND
R24: 39k; R_Axial_DIN0414_L11.9mm_D4.5mm_P15.24mm_Horizontal; Manufacturer_Part_Number CF12JT39K0; Digikey part number CF12JT39K0CT-ND
R25, R26, R29: 10k; R_0603_1608Metric_Pad0.98x0.95mm_HandSolder; Manufacturer_Part_Number RK73H1JTTD1002F; Digikey part number 2019-RK73H1JTTD1002FCT-ND
R27: 15k; R_0603_1608Metric_Pad0.98x0.95mm_HandSolder; Manufacturer_Part_Number ERA-3AEB153V; Digikey part number P15KDBCT-ND
R28: 1k; R_0603_1608Metric_Pad0.98x0.95mm_HandSolder; Manufacturer_Part_Number RMCF0603FT1K00; Digikey part number RMCF0603FT1K00CT-ND
R30: 0.15; R_0603_1608Metric_Pad0.98x0.95mm_HandSolder; Manufacturer_Part_Number RL0603FR-070R15L; Digikey part number 311-.15QCT-ND
R31: 100; R_1206_3216Metric_Pad1.30x1.75mm_HandSolder; Manufacturer_Part_Number ERJ-8ENF1000V; Digikey part number P100FCT-ND
U5: LTV-817S; SMDIP-4_W9.53mm; Manufacturer_Part_Number LTV-817S; Digikey part number 160-1367-5-ND
U6: ICM7555xB; SOIC-8_3.9x4.9mm_P1.27mm; Manufacturer_Part_Number ICM7555CBAZ-T; Digikey part number ICM7555CBAZ-TCT-ND
U7: IS31LT3360; SOT-89-5; Manufacturer_Part_Number IS31LT3360-SDLS4-TR; Digikey part number 2521-IS31LT3360-SDLS4-TRCT-ND

Connections:
/Connectors/TSAL_GND: L1.2; also elsewhere on the board
/Connectors/TSAL_PWR: Q2.2 (C), Q2.4 (C), R30.2, R31.2, U7.4 (ISENSE); also elsewhere on the board
/High Voltage/TSAL/555_OUT: R27.1, R28.1, R29.1, U6.3 (Q)
/High Voltage/TSAL/HV+: R24.1; also elsewhere on the board
/High Voltage/TSAL/HV-: U5.2; also elsewhere on the board
/High Voltage/TSAL/HV_ON: R25.1, U5.3, U6.4 (R)
/High Voltage/TSAL/pass: C11.1, R27.2, U6.2 (TR), U6.6 (THR)
GND: C9.2, C10.2, C11.2, C12.1, C13.1, R25.2, R31.1, U6.1 (GND), U7.2 (GND); also elsewhere on the board
INT_12V: C12.2, C13.2, D9.1 (K), Q2.3 (E), R30.1, U7.5 (VIN); also elsewhere on the board
unnamed: D9.2 (A), L1.1, U7.1 (LX)
unnamed: Q2.1 (B), R28.2
unnamed: R24.2, U5.1
unnamed: C9.1, U6.5 (CV)
unnamed: R26.1, U6.7 (DIS)
unnamed: R29.2, U7.3 (ADJ)
VDD: C10.1, R26.2, U5.4, U6.8 (VCC); also elsewhere on the board

Notes on the sheet:
Change HV On sig to either BMS or IMD fault from micro
*Optional just in case LED Drive does not work
LED Driver
High Voltage
HV Input
Timer
Change TSAL to TSSI_RED_PWR,

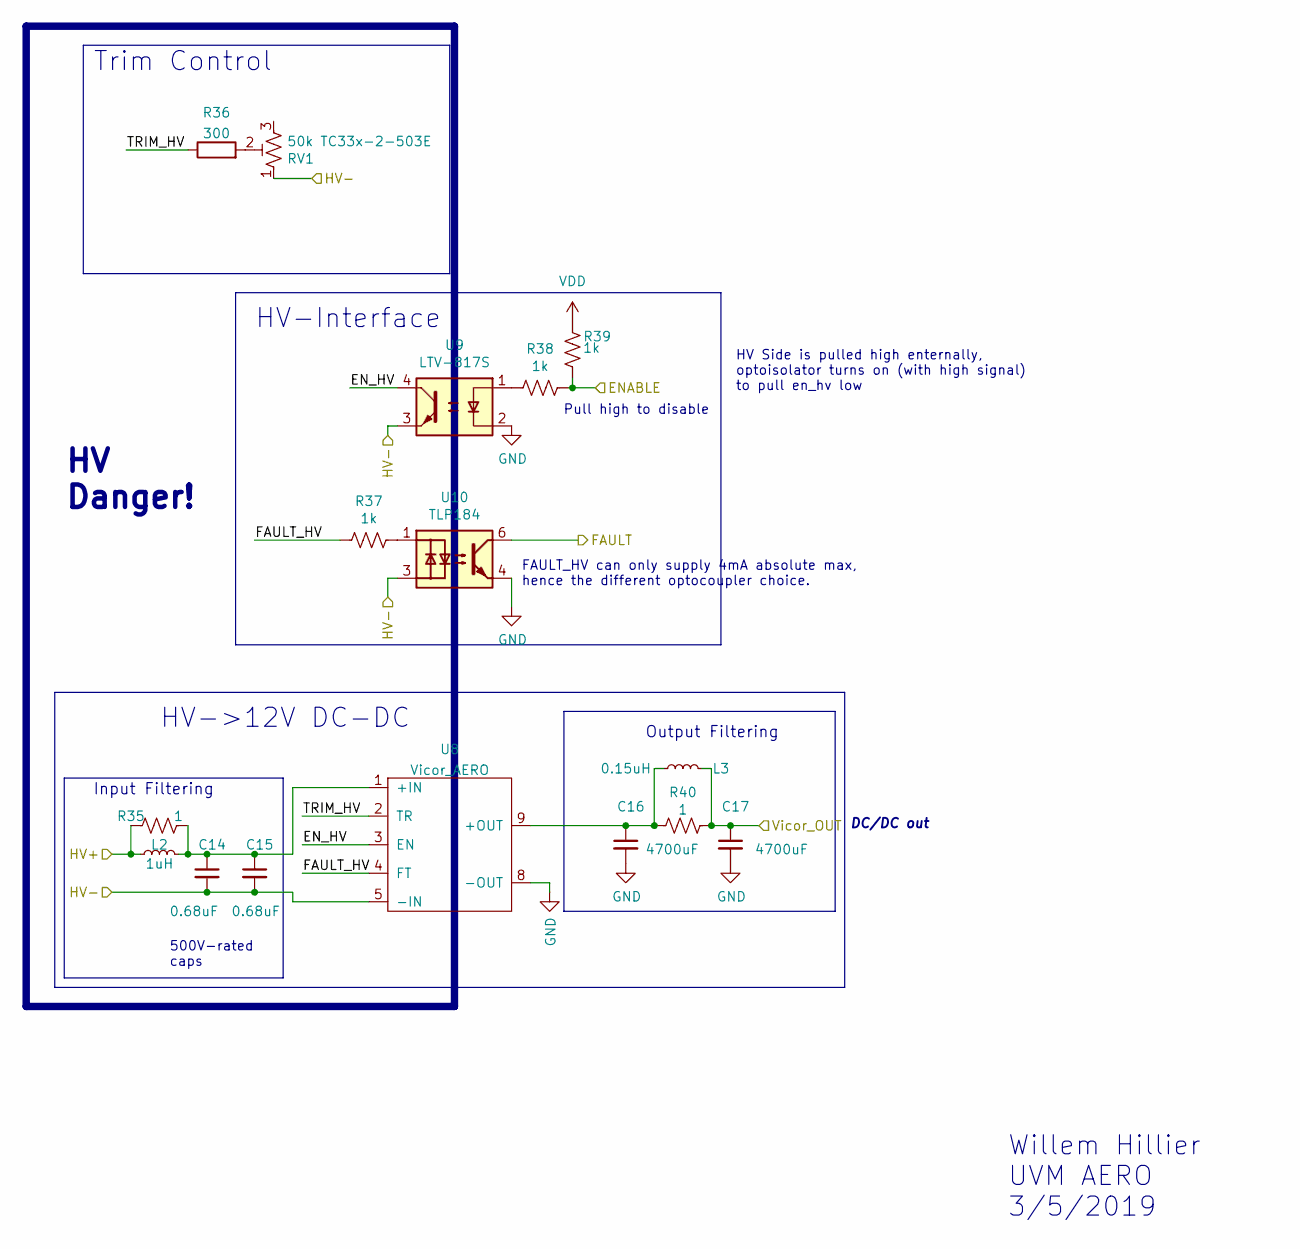
[picture p9: schematic DCDC.kicad_sch]

Parts:
C14, C15: 0.68uF; C_Rect_L18.0mm_W8.0mm_P15.00mm_FKS3_FKP3
C16, C17: 4700uF; C_Radial_D18.0mm_H35.5mm_P7.50mm
L2: 1uH; L_1008_2520Metric_Pad1.43x2.20mm_HandSolder; Manufacturer_Part_Number LQM2HPN1R0MG0L; Digikey part number 490-5112-1-ND
L3: 0.15uH; L_0805_2012Metric_Pad1.15x1.40mm_HandSolder; Manufacturer_Part_Number CE201210-R15J; Digikey part number CE201210-R15JCT-ND
R35, R40: 1; R_2512_6332Metric_Pad1.40x3.35mm_HandSolder; Manufacturer_Part_Number RK73H1JTTD1002F; Digikey part number 2019-RK73H1JTTD1002FCT-ND
R36: 300; R_0603_1608Metric_Pad0.98x0.95mm_HandSolder; Manufacturer_Part_Number ERJ-3GEYJ301V; Digikey part number P300GCT-ND
R37, R38, R39: 1k; R_0603_1608Metric_Pad0.98x0.95mm_HandSolder; Manufacturer_Part_Number RMCF0603FT1K00; Digikey part number RMCF0603FT1K00CT-ND
RV1: 50k TC33x-2-503E; Potentiometer_Bourns_TC33X_Vertical; Manufacturer_Part_Number TC33X-2-503E; Digikey part number TC33X-503ECT-ND
U8: Vicor_AERO; vicor-socket-no-cutouts
U9: LTV-817S; SMDIP-4_W9.53mm; Manufacturer_Part_Number LTV-817S; Digikey part number 160-1367-5-ND
U10: TLP184; MFSOP6-4_4.4x3.6mm_P1.27mm; Manufacturer_Part_Number TLP184(BL-TPL,SE; Digikey part number TLP184(BL-TPLSECT-ND

Connections:
/Fusing/Vicor_In: C17.1, L3.2, R40.1; also elsewhere on the board
/High Voltage/DCDC/EN_HV: U8.3 (EN), U9.4
/High Voltage/DCDC/FAULT_HV: R37.2, U8.4 (FT)
/High Voltage/DCDC/HV+: L2.1, R35.2; also elsewhere on the board
/High Voltage/DCDC/HV-: C14.2, C15.2, RV1.1, U8.5 (-IN), U9.3, U10.3; also elsewhere on the board
/High Voltage/DCDC/TRIM_HV: R36.1, U8.2 (TR)
/High Voltage/Vicor_Enable: R38.1, R39.2; also elsewhere on the board
/High Voltage/Vicor_Fault: U10.6; also elsewhere on the board
GND: C16.2, C17.2, U8.8 (-OUT), U9.2, U10.4; also elsewhere on the board
unnamed: R36.2, RV1.2
unnamed: R37.1, U10.1
unnamed: R38.2, U9.1
unnamed: C14.1, C15.1, L2.2, R35.1, U8.1 (+IN)
unnamed: C16.1, L3.1, R40.2, U8.9 (+OUT)
VDD: R39.1; also elsewhere on the board

Notes on the sheet:
HV Side is pulled high enternally, optoisolator turns on (with high signal) to pull en_hv low
Willem Hillier UVM AERO 3/5/2019
Trim Control
Input Filtering
HV->12V DC-DC
DC/DC out
Output Filtering
HV Danger!
Pull high to disable
500V-rated caps
HV-Interface
FAULT_HV can only supply 4mA absolute max, hence the different optocoupler choice.

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
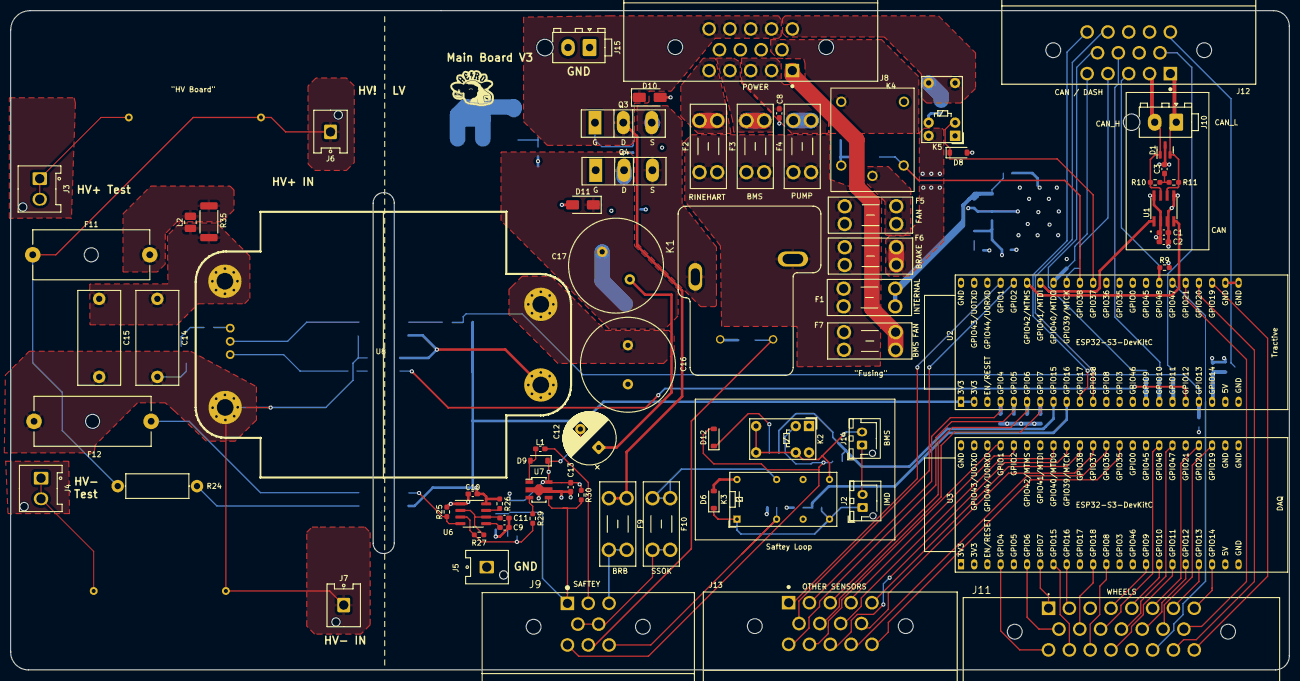
[picture p10: board Big Daddy.kicad_pcb from above]

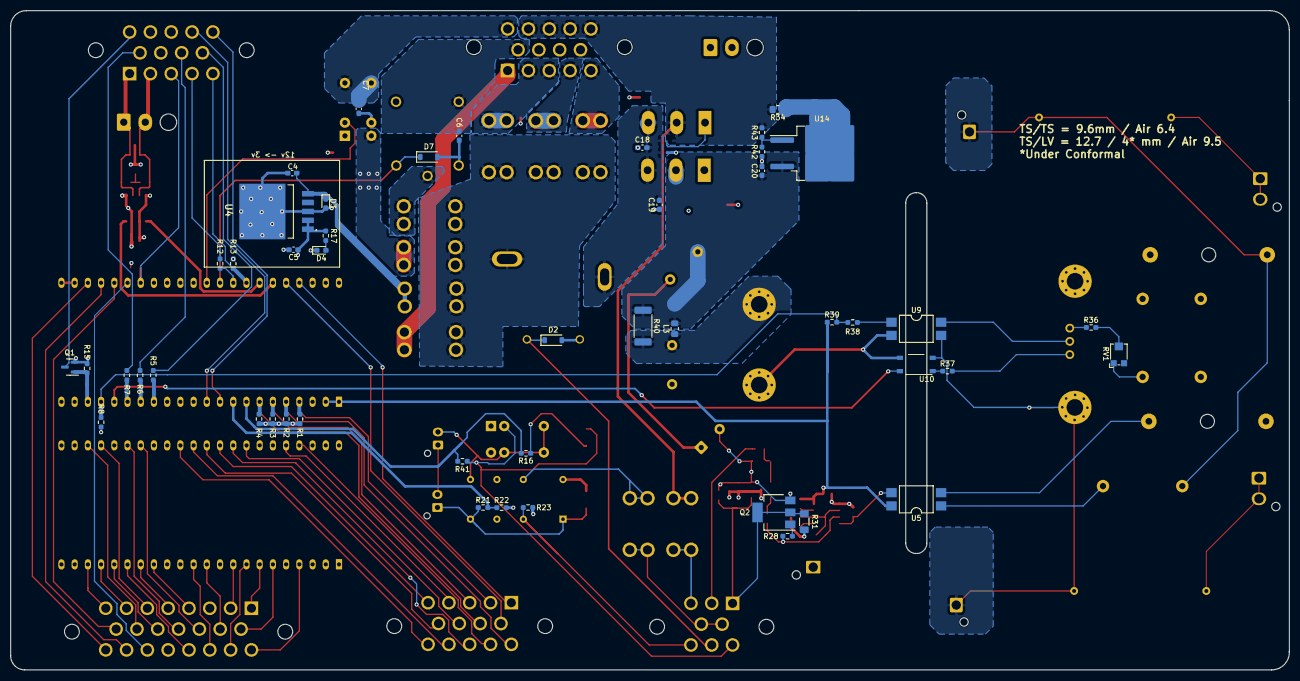
[picture p11: board Big Daddy.kicad_pcb from below]

Board: 4 copper layers, 245.7 x 126.7 mm, 119 parts (47 on the bottom side), 112 nets.

Other parts of the board:
R41: 2.2k; R_0603_1608Metric_Pad0.98x0.95mm_HandSolder
